kbaxter3/GamingArmband/PCB/sensingBoard/sensingBoard.kicad_pcb

## KiCad design PCB/sensingBoard/sensingBoard.kicad_pcb (2024-03-26)

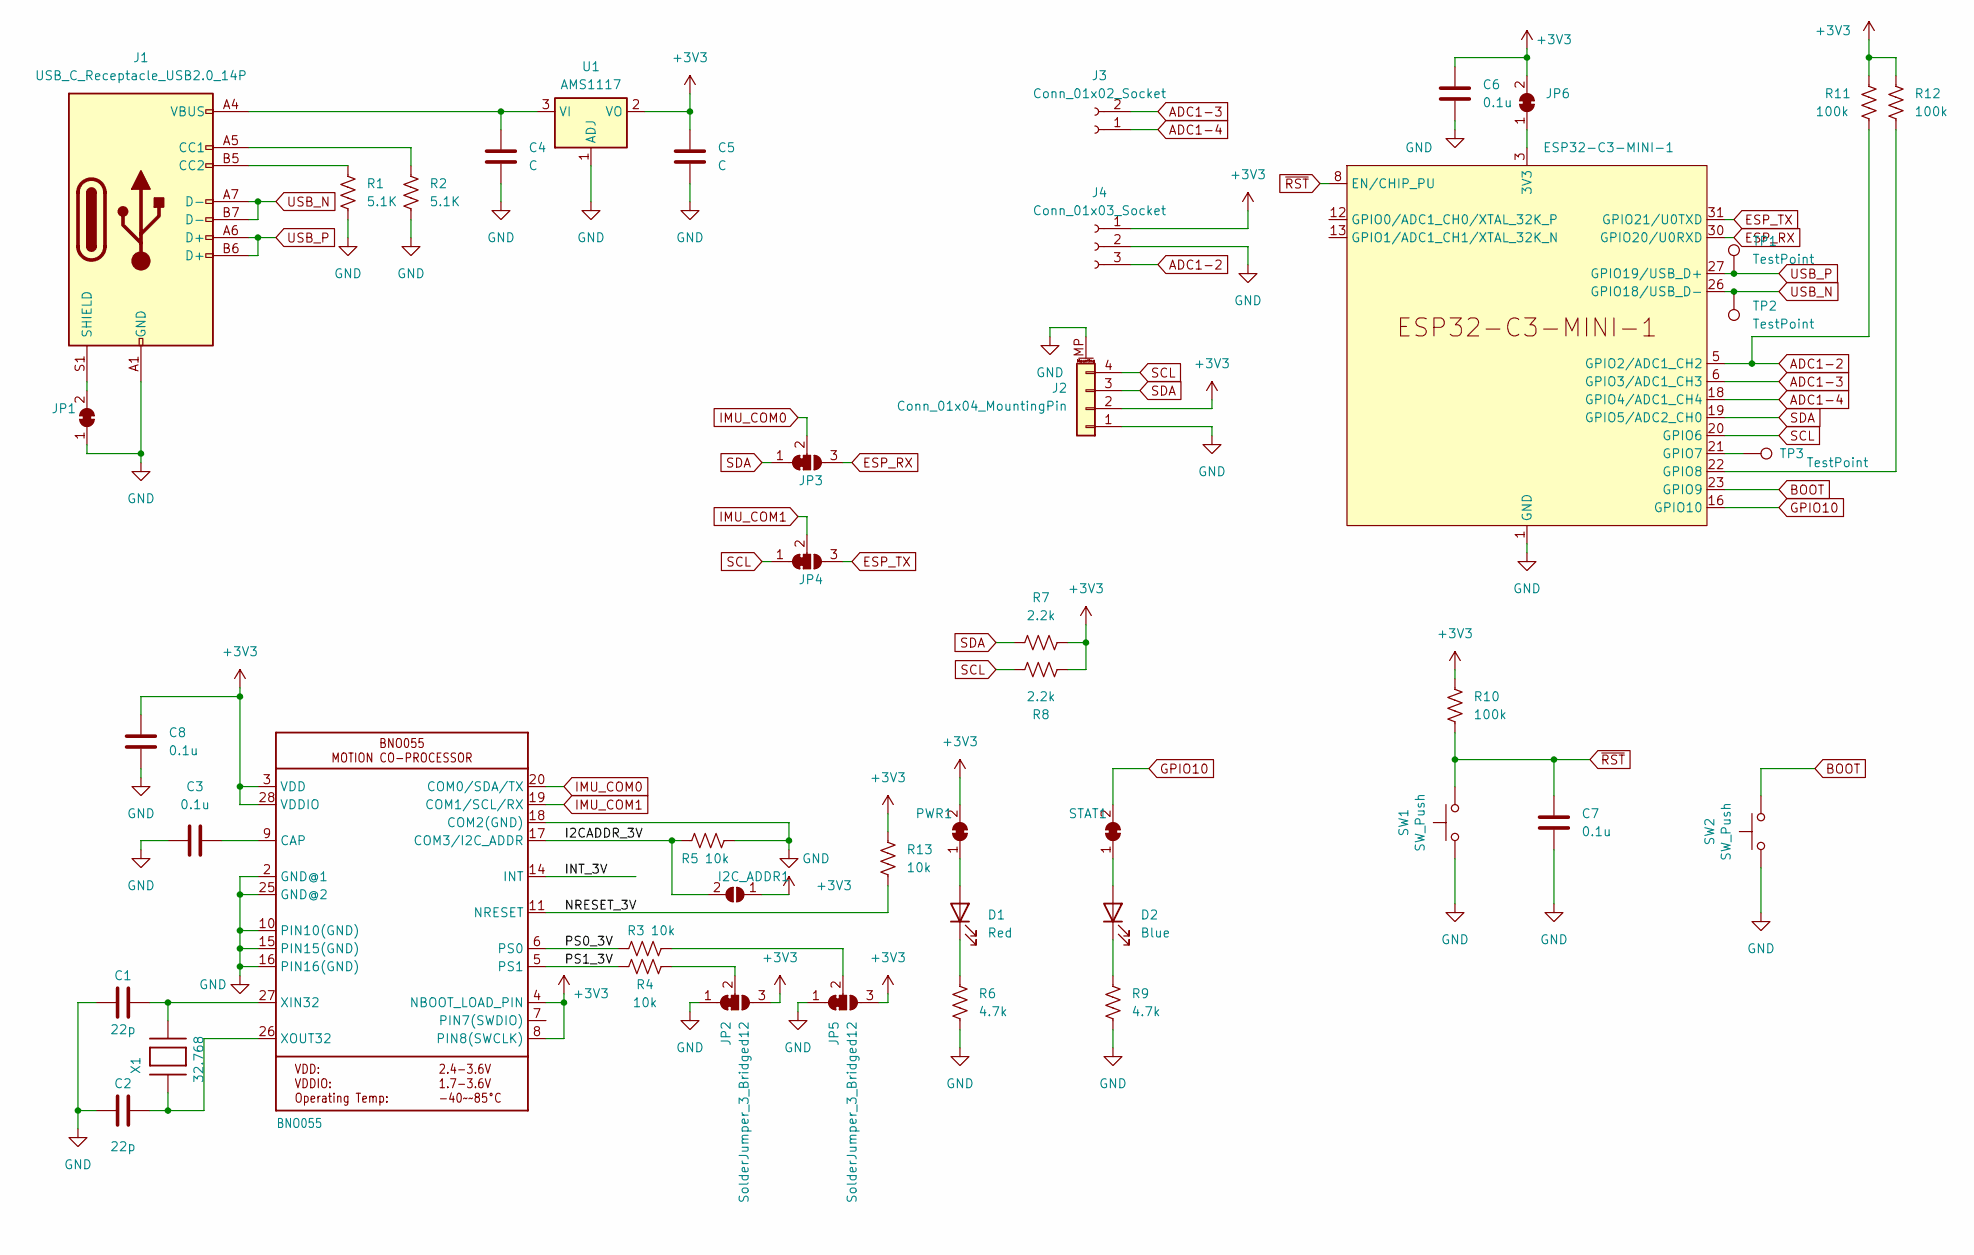
[picture p1: schematic sensingBoard.kicad_sch]

Parts:
C1, C2: 22p; C_0805_2012Metric_Pad1.18x1.45mm_HandSolder
C3, C6, C7, C8: 0.1u; C_0805_2012Metric_Pad1.18x1.45mm_HandSolder
C4, C5: C; C_0805_2012Metric_Pad1.18x1.45mm_HandSolder
D1: Red; LED_0805_2012Metric_Pad1.15x1.40mm_HandSolder
D2: Blue; LED_0805_2012Metric_Pad1.15x1.40mm_HandSolder
I2C_ADDR1: SolderJumper-2_P1.3mm_Open_RoundedPad1.0x1.5mm
J1: USB_C_Receptacle_USB2.0_14P; USB_C_Receptacle_GCT_USB4105-xx-A_16P_TopMnt_Horizontal
J2: Conn_01x04_MountingPin; JST_SH_BM04B-SRSS-TB_1x04-1MP_P1.00mm_Vertical
J3: Conn_01x02_Socket; PinSocket_1x02_P2.54mm_Vertical
J4: Conn_01x03_Socket; PinSocket_1x03_P2.54mm_Vertical
JP1, JP6: SolderJumper-2_P1.3mm_Bridged_RoundedPad1.0x1.5mm
JP2, JP3, JP4, JP5: SolderJumper_3_Bridged12; SolderJumper-3_P1.3mm_Bridged12_RoundedPad1.0x1.5mm
PWR1: SolderJumper-2_P1.3mm_Bridged_RoundedPad1.0x1.5mm
R1, R2: 5.1K; R_0805_2012Metric_Pad1.20x1.40mm_HandSolder
R3, R4, R5, R13: 10k; R_0805_2012Metric_Pad1.20x1.40mm_HandSolder
R6, R9: 4.7k; R_0805_2012Metric_Pad1.20x1.40mm_HandSolder
R7, R8: 2.2k; R_0805_2012Metric_Pad1.20x1.40mm_HandSolder
R10, R11, R12: 100k; R_0805_2012Metric_Pad1.20x1.40mm_HandSolder
STAT1: SolderJumper-2_P1.3mm_Bridged_RoundedPad1.0x1.5mm
SW1, SW2: SW_Push; SMD_Pushbutton_3mmx4mm
TP1, TP2, TP3: TestPoint; TestPoint_Pad_D1.0mm
U1: AMS1117; SOT-223-3_TabPin2
U2: ESP32-C3-MINI-1
U$1: BNO055
X1: 32.768; XTAL3215

Connections:
+3V3: C5.1, C6.1, C8.1, I2C_ADDR1.1 (A), J2.2, J4.1, JP2.3 (B), JP5.3 (B), JP6.2 (B), PWR1.2 (B), R7.2, R8.1, R10.1, R11.1, R12.1, R13.1, U1.2 (VO), U$1.3 (VDD), U$1.4 (NBOOT_LOAD_PIN), U$1.8 (PIN8(SWCLK)), U$1.28 (VDDIO)
/I2CADDR_3V: I2C_ADDR1.2 (B), R5.1, U$1.17 (COM3/I2C_ADDR)
/INT_3V: U$1.14 (INT)
/NRESET_3V: R13.2, U$1.11 (NRESET)
/PS0_3V: R3.1, U$1.6 (PS0)
/PS1_3V: R4.1, U$1.5 (PS1)
ADC1-2: J4.3, R11.2, U2.5 (GPIO2/ADC1_CH2)
ADC1-3: J3.2, U2.6 (GPIO3/ADC1_CH3)
ADC1-4: J3.1, U2.18 (GPIO4/ADC1_CH4)
BOOT: SW2.2, U2.23 (GPIO9)
ESP_RX: JP3.3 (B), U2.30 (GPIO20/U0RXD)
ESP_TX: JP4.3 (B), U2.31 (GPIO21/U0TXD)
GND: C1.1, C2.1, C3.1, C4.2, C5.2, C6.2, C7.2, C8.2, J1.A1 (GND), J1.A12 (GND), J1.B1 (GND), J1.B12 (GND), J2.1, J2.MP (MountPin), J4.2, JP1.1 (A), JP2.1 (A), JP5.1 (A), R1.2, R2.2, R5.2, R6.2, R9.2, SW1.1, SW2.1, U1.1 (ADJ), U2.1 (GND), U2.2 (GND), U2.11 (GND), U2.14 (GND), U2.36 (GND), U2.37 (GND), U2.38 (GND), U2.39 (GND), U2.40 (GND), U2.41 (GND), U2.42 (GND), U2.43 (GND), U2.44 (GND), U2.45 (GND), U2.46 (GND), U2.47 (GND), U2.48 (GND), U2.49 (GND), U2.50 (GND), U2.51 (GND), U2.52 (GND), U2.53 (GND), U$1.2 (GND@1), U$1.10 (PIN10(GND)), U$1.15 (PIN15(GND)), U$1.16 (PIN16(GND)), U$1.18 (COM2(GND)), U$1.25 (GND@2)
GPIO10: STAT1.2 (B), U2.16 (GPIO10)
IMU_COM0: JP3.2 (C), U$1.20 (COM0/SDA/TX)
IMU_COM1: JP4.2 (C), U$1.19 (COM1/SCL/RX)
unnamed: D1.2 (A), PWR1.1 (A)
unnamed: D1.1 (K), R6.1
unnamed: D2.2 (A), STAT1.1 (A)
unnamed: D2.1 (K), R9.1
unnamed: J1.A5 (CC1), R2.1
unnamed: J1.B5 (CC2), R1.1
unnamed: J1.S1 (SHIELD), JP1.2 (B)
unnamed: JP2.2 (C), R4.2
unnamed: JP5.2 (C), R3.2
unnamed: JP6.1 (A), U2.3 (3V3)
unnamed: C4.1, J1.A4 (VBUS), J1.A9 (VBUS), J1.B4 (VBUS), J1.B9 (VBUS), U1.3 (VI)
unnamed: TP3.1, U2.21 (GPIO7)
unnamed: R12.2, U2.22 (GPIO8)
unnamed: C3.2, U$1.9 (CAP)
unnamed: C1.2, U$1.27 (XIN32), X1.P$2
unnamed: C2.2, U$1.26 (XOUT32), X1.P$1
SCL: J2.4, JP4.1 (A), R8.2, U2.20 (GPIO6)
SDA: J2.3, JP3.1 (A), R7.1, U2.19 (GPIO5/ADC2_CH0)
USB_N: J1.A7 (D-), J1.B7 (D-), TP2.1, U2.26 (GPIO18/USB_D-)
USB_P: J1.A6 (D+), J1.B6 (D+), TP1.1, U2.27 (GPIO19/USB_D+)
~RST: C7.1, R10.2, SW1.2, U2.8 (EN/CHIP_PU)

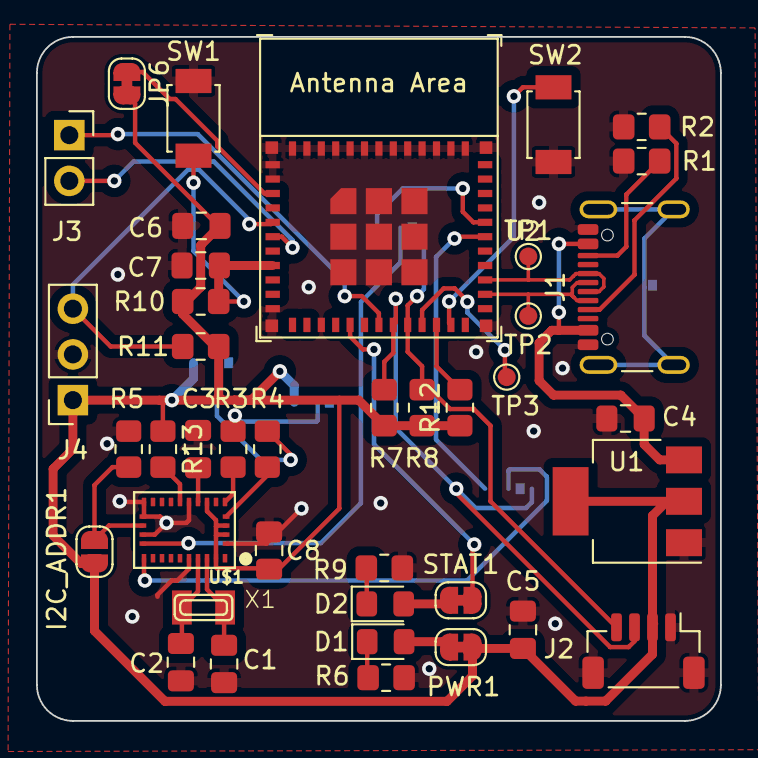
[picture p2: board sensingBoard.kicad_pcb from above]

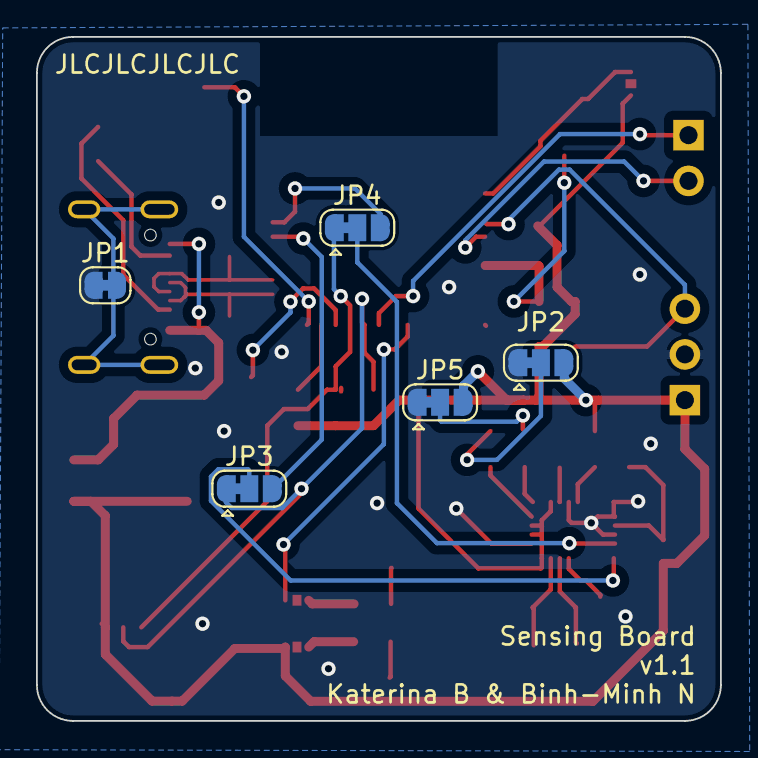
[picture p3: board sensingBoard.kicad_pcb from below]

Board: 2 copper layers, 38.0 x 38.0 mm, 45 parts (5 on the bottom side), 36 nets.
