kbaxter3/GamingArmband/(commit log)

2024-03-02 Added PCB and created test code to collect data
    [sensingBoard-B_Cu.gbl, sensingBoard-B_Mask.gbs, sensingBoard-B_Paste.gbp, sensingBoard-B_Silkscreen.gbo, sensingBoard-Edge_Cuts.gm1, sensingBoard-F_Cu.gtl, sensingBoard-F_Mask.gts, sensingBoard-F_Paste.gtp]
2024-03-20 board v1
2024-03-24 modified sensor board and wrote firmware for wireless data transfer
    [sensingBoard.kicad_pcb, sensingBoard.kicad_sch]
2024-03-26 gitignore for kicad backup, added pullup for nreset on imu
    [sensingBoard.kicad_pcb, sensingBoard.kicad_sch]
2024-03-28 communication between ESP32 receiver and arduino
2024-04-02 up/down arrow w/ imu, started emg control, WIP
2024-04-04 Added 3D Vector Graph and fixed EMG scaling issue
    [dataTestPython.py]
2024-04-04 adjusted emg control cutoffs and added sensor board firmware without serial
